monti-tls/repico/RESOURCES.md

Architecture drawing :
  https://docs.google.com/drawings/d/1vPpEyib8iVg671A2u_ITs0JO-gHoYBtKFvb20q2bAPQ/edit

GPIO .dts overlay generator :
  http://kilobaser.com/blog/2014-07-28-beaglebone-black-devicetreeoverlay-generator
