monti-tls/repico/simulation/dda/supply_switch/mosfet_test.asc

M1: nmos; TSM2314CX
R1: res; 1
V1: voltage; 5
V2: voltage; 5
Named nets: 0
.include TSM2314CX.lib
.tran 200m
