monti-tls/repico/simulation/pwm_module/pwm_module.asc

C1: cap; 47µ
C2: cap; 100n
C3: cap; 47µ
C4: cap; 100n
D1: diode; S1D
L1: ind; 0.1µ
Q1: npn; BC847C
Q2: npn; BC847C
Q3: npn; BC847C
Q4: pnp; BC857C
R1: res; 330
R2: res; 3.3K
R3: res; 470
R4: res; 3.3K
R5: res; 4.7
R6: res; 22
R7: res; 3.3
R8: res2; 5; pwr=25
U1: PSMN8R7_80PS
V1: voltage; PULSE(0 3.3 0.2ms 0 0 0.05ms 0.1ms)
V2: voltage; 12
Named nets: 0, VDD, S
.tran 2ms
.lib S1D.lib
.lib PSMN8R7_80PS.lib
