monti-tls/repico/simulation/dda/relay/relay.asc

Q1: npn; BC847C
R1: res; 4K7
R2: res2; 225
R3: res; 20K
V1: voltage; 12
V2: voltage; PULSE(0 3.3 1ms 0 0 1ms 2ms 1)
Named nets: VCC, 0, S
.tran 10ms
