monti-tls/repico/simulation/dda/stepper_leds/stepper_leds.asc

D1: LED
Q1: npn; BC847C
Q2: npn; BC847C
R1: res; 10K
R2: res; 560
R3: res; 4.7K
R4: res; 560
V1: voltage; 12
V2: voltage; PULSE(3.3 0 5ms 0 0 5ms 10ms 1)
Named nets: VCC, 0, S
.tran 15ms
