monti-tls/repico/simulation/dda/supply_switch/supply_switch.asc

C2: cap; 10µ
M1: pmos; RTQ035P02
Q1: npn; BC847C
R1: res; 20k
R3: res; 20k
R4: res2; 3
R5: res; 0
R6: res; 10k
R7: res; 4.7k
V1: voltage; 3.3
V2: voltage; PULSE(0 3.3 10m 0 0 100m 0 1)
Named nets: enbl, 0
.tran 200m
