monti-tls/repico/simulation/dda/switch_debounce/switch_debounce.asc

C1: cap; 100n
D1: diode; 1N4148
R1: res; 3.3K
R2: res; 3.3K
S1: sw; SWITCH
U1: 74hc132; VCC=3.3  SPEED=1.0  TRIPDT=1e-9
V1: voltage; PULSE(0 1 1ms 0 0 0.08ms 0.16ms 5)
V2: voltage; 3.3
V3: voltage; PULSE(0 1 1.8ms 0 0 2ms 2ms)
Named nets: 0, VCC, S
.lib 74hc.lib
.tran 10ms
.model SWITCH SW(Ron=1m Roff=1Meg Vt=0.5 Vh=0.4)
