monti-tls/repico/hardware/dda/dda.brd

## EAGLE design hardware/dda/dda.brd (2016-12-25)

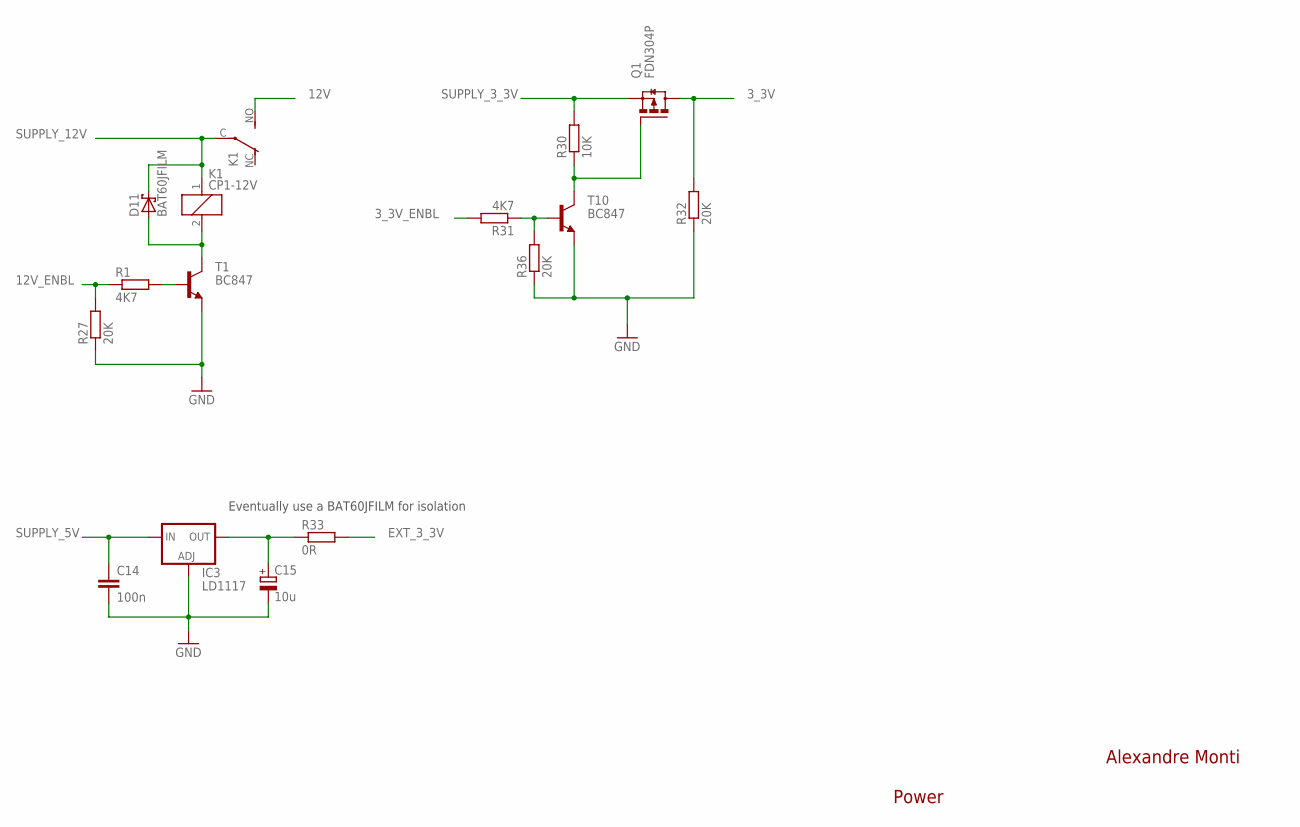
[picture p1: schematic dda.sch, sheet 1, Power]

Parts:
C14: 100n; C0805; PARTNO 2496944
C15: 10u; CT3216; PARTNO 1432339
D11: BAT60JFILM; SOD323_ST; PARTNO 1467544
IC3: LD1117; SOT223; PARTNO 1202826
K1: CP1-12V; CP1; PARTNO 2103582
Q1: FDN304P; SUPER-SOT3; PARTNO 9846298
R1, R31: 4K7; M0805; PARTNO 9333266
R27, R32, R36: 20K; M0805; PARTNO 9332774
R30: 10K; M0805; PARTNO 9332391
R33: 0R; R0805W; PARTNO 9333681
T1, T10: BC847; SOT23; PARTNO 2432696

Connections:
3_3V: Q1.3 (D), R32.2; also elsewhere on the board
3_3V_ENBL: R31.2; also elsewhere on the board
12V: K1.NO (S); also elsewhere on the board
12V_ENBL: R1.1, R27.2; also elsewhere on the board
EXT_3_3V: R33.2; also elsewhere on the board
GND: C14.2, C15.-, IC3.1 (ADJ), R27.1, R32.1, R36.1, T1.2 (E), T10.2 (E); also elsewhere on the board
unnamed: Q1.1 (G), R30.1, T10.3 (C)
unnamed: R31.1, R36.2, T10.1 (B)
unnamed: C15.+, IC3.4 (OUT), R33.1
unnamed: D11.A, K1.2, T1.3 (C)
unnamed: R1.2, T1.1 (B)
SUPPLY_3_3V: Q1.2 (S), R30.2; also elsewhere on the board
SUPPLY_5V: C14.1, IC3.3 (IN); also elsewhere on the board
SUPPLY_12V: D11.C, K1.1, K1.C; also elsewhere on the board

Notes on the sheet:
Alexandre Monti
Eventually use a BAT60JFILM for isolation
Power

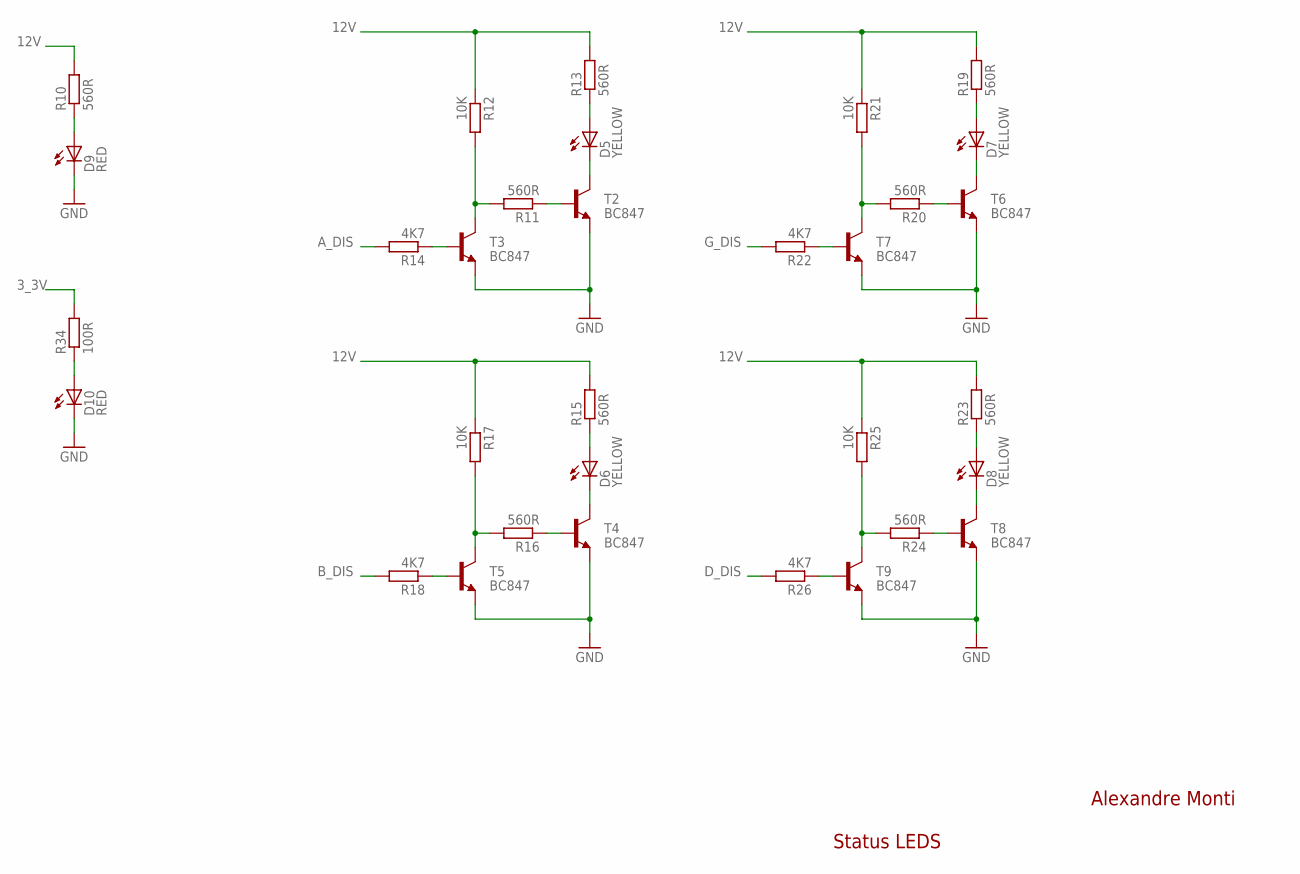
[picture p2: schematic dda.sch, sheet 2, LEDs]

Parts:
D5, D6, D7, D8: YELLOW; CHIP-LED0805; PARTNO 1581241
D9, D10: RED; CHIP-LED0805; PARTNO 1581239
R10, R11, R13, R15, R16, R19, R20, R23, R24: 560R; M0805; PARTNO 9334688
R12, R17, R21, R25: 10K; M0805; PARTNO 9332391
R14, R18, R22, R26: 4K7; M0805; PARTNO 9333266
R34: 100R; M0805; PARTNO 9237364
T2, T3, T4, T5, T6, T7, T8, T9: BC847; SOT23; PARTNO 2432696

Connections:
3_3V: R34.2; also elsewhere on the board
12V: R10.2, R12.1, R13.2, R15.2, R17.1, R19.2, R21.1, R23.2, R25.1; also elsewhere on the board
A_DIS: R14.2; also elsewhere on the board
B_DIS: R18.2; also elsewhere on the board
D_DIS: R26.2; also elsewhere on the board
GND: D9.C, D10.C, T2.2 (E), T3.2 (E), T4.2 (E), T5.2 (E), T6.2 (E), T7.2 (E), T8.2 (E), T9.2 (E); also elsewhere on the board
G_DIS: R22.2; also elsewhere on the board
unnamed: D10.A, R34.1
unnamed: D5.C, T2.3 (C)
unnamed: D5.A, R13.1
unnamed: R11.1, T2.1 (B)
unnamed: R11.2, R12.2, T3.3 (C)
unnamed: D6.C, T4.3 (C)
unnamed: R14.1, T3.1 (B)
unnamed: D6.A, R15.1
unnamed: R16.1, T4.1 (B)
unnamed: R16.2, R17.2, T5.3 (C)
unnamed: R18.1, T5.1 (B)
unnamed: D7.C, T6.3 (C)
unnamed: D7.A, R19.1
unnamed: R20.1, T6.1 (B)
unnamed: R20.2, R21.2, T7.3 (C)
unnamed: R22.1, T7.1 (B)
unnamed: D8.C, T8.3 (C)
unnamed: D8.A, R23.1
unnamed: R24.1, T8.1 (B)
unnamed: R24.2, R25.2, T9.3 (C)
unnamed: R26.1, T9.1 (B)
unnamed: D9.A, R10.1

Notes on the sheet:
Alexandre Monti
Status LEDS

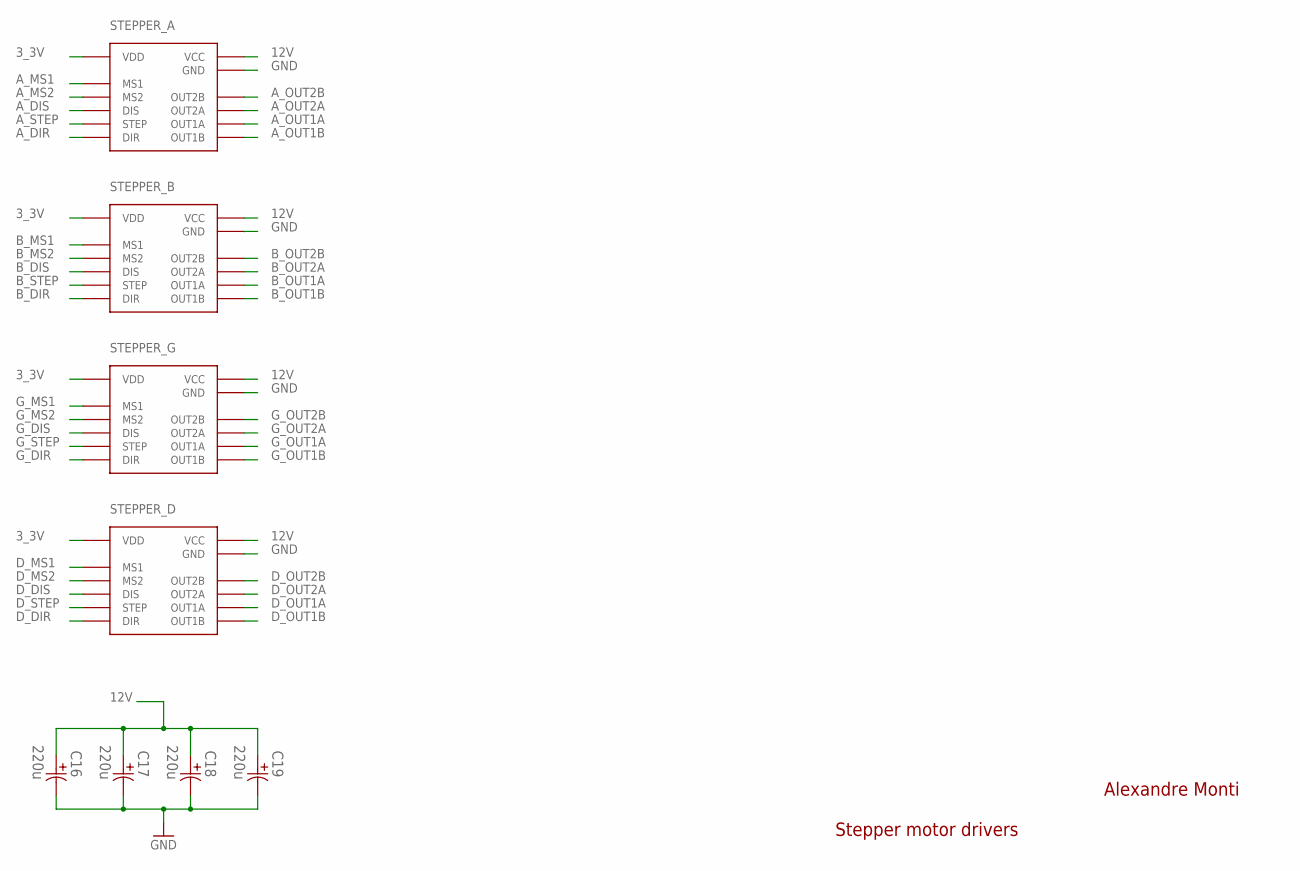
[picture p3: schematic dda.sch, sheet 3, Steppers]

Parts:
C16, C17, C18, C19: 220u; CAPAE660X800N; PARTNO 1868409
STEPPER_A: REPICO_STEPPER; PARTNO 1593462
STEPPER_B: REPICO_STEPPER; PARTNO 1593462
STEPPER_D: REPICO_STEPPER; PARTNO 1593462
STEPPER_G: REPICO_STEPPER; PARTNO 1593462

Connections:
3_3V: STEPPER_A.VDD, STEPPER_B.VDD, STEPPER_D.VDD, STEPPER_G.VDD; also elsewhere on the board
12V: C16.1, C17.1, C18.1, C19.1, STEPPER_A.VCC, STEPPER_B.VCC, STEPPER_D.VCC, STEPPER_G.VCC; also elsewhere on the board
A_DIR: STEPPER_A.DIR; also elsewhere on the board
A_DIS: STEPPER_A.DIS; also elsewhere on the board
A_MS1: STEPPER_A.MS1; also elsewhere on the board
A_MS2: STEPPER_A.MS2; also elsewhere on the board
A_OUT1A: STEPPER_A.OUT1A; also elsewhere on the board
A_OUT1B: STEPPER_A.OUT1B; also elsewhere on the board
A_OUT2A: STEPPER_A.OUT2A; also elsewhere on the board
A_OUT2B: STEPPER_A.OUT2B; also elsewhere on the board
A_STEP: STEPPER_A.STEP; also elsewhere on the board
B_DIR: STEPPER_B.DIR; also elsewhere on the board
B_DIS: STEPPER_B.DIS; also elsewhere on the board
B_MS1: STEPPER_B.MS1; also elsewhere on the board
B_MS2: STEPPER_B.MS2; also elsewhere on the board
B_OUT1A: STEPPER_B.OUT1A; also elsewhere on the board
B_OUT1B: STEPPER_B.OUT1B; also elsewhere on the board
B_OUT2A: STEPPER_B.OUT2A; also elsewhere on the board
B_OUT2B: STEPPER_B.OUT2B; also elsewhere on the board
B_STEP: STEPPER_B.STEP; also elsewhere on the board
D_DIR: STEPPER_D.DIR; also elsewhere on the board
D_DIS: STEPPER_D.DIS; also elsewhere on the board
D_MS1: STEPPER_D.MS1; also elsewhere on the board
D_MS2: STEPPER_D.MS2; also elsewhere on the board
D_OUT1A: STEPPER_D.OUT1A; also elsewhere on the board
D_OUT1B: STEPPER_D.OUT1B; also elsewhere on the board
D_OUT2A: STEPPER_D.OUT2A; also elsewhere on the board
D_OUT2B: STEPPER_D.OUT2B; also elsewhere on the board
D_STEP: STEPPER_D.STEP; also elsewhere on the board
GND: C16.2, C17.2, C18.2, C19.2, STEPPER_A.GND, STEPPER_B.GND, STEPPER_D.GND, STEPPER_G.GND; also elsewhere on the board
G_DIR: STEPPER_G.DIR; also elsewhere on the board
G_DIS: STEPPER_G.DIS; also elsewhere on the board
G_MS1: STEPPER_G.MS1; also elsewhere on the board
G_MS2: STEPPER_G.MS2; also elsewhere on the board
G_OUT1A: STEPPER_G.OUT1A; also elsewhere on the board
G_OUT1B: STEPPER_G.OUT1B; also elsewhere on the board
G_OUT2A: STEPPER_G.OUT2A; also elsewhere on the board
G_OUT2B: STEPPER_G.OUT2B; also elsewhere on the board
G_STEP: STEPPER_G.STEP; also elsewhere on the board

Notes on the sheet:
Stepper motor drivers
Alexandre Monti

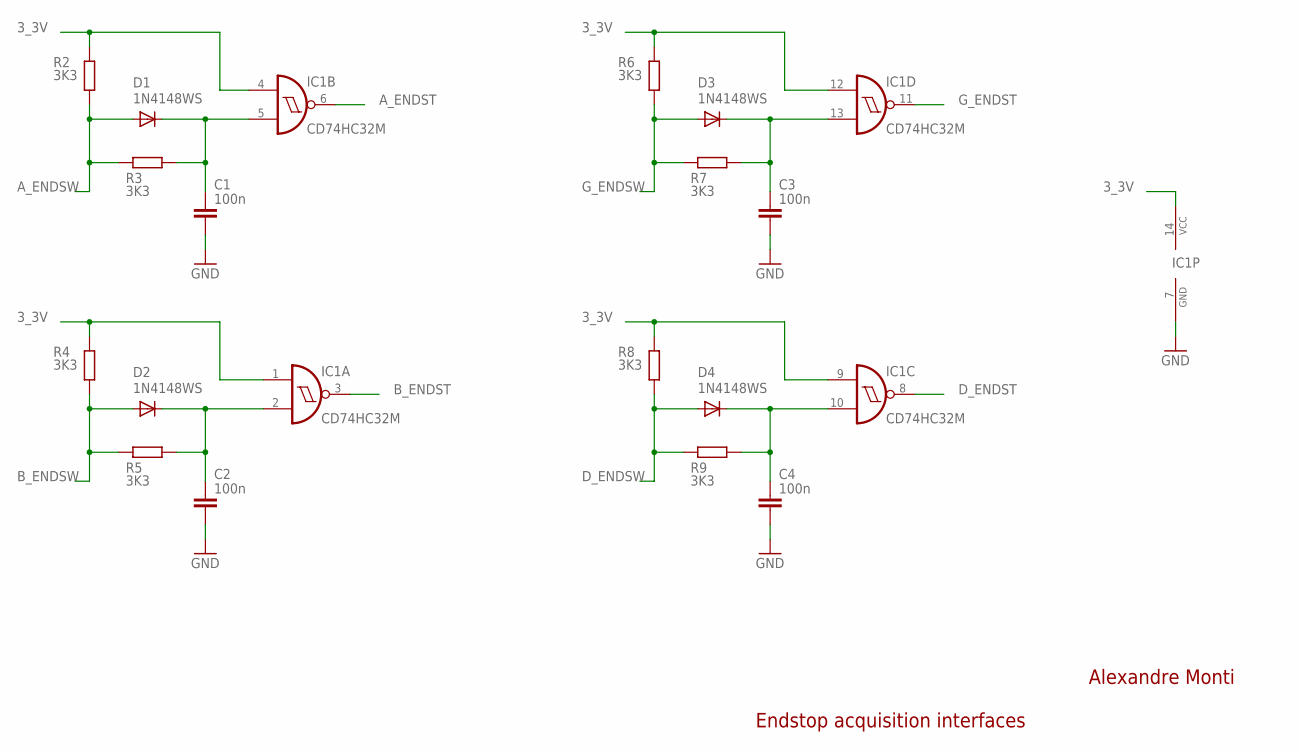
[picture p4: schematic dda.sch, sheet 4, Endstops]

Parts:
C1, C2, C3, C4: 100n; C0805; PARTNO 2496944
D1, D2, D3, D4: 1N4148WS; SOD123; PARTNO 1466524
IC1: CD74HC32M; SO14; PARTNO 1103158
R2, R3, R4, R5, R6, R7, R8, R9: 3K3; M0805; PARTNO 9333045

Connections:
3_3V: IC1.1 (I0), IC1.4 (I0), IC1.9 (I0), IC1.12 (I0), IC1.14 (VCC), R2.2, R4.2, R6.2, R8.2; also elsewhere on the board
A_ENDST: IC1.6 (O); also elsewhere on the board
A_ENDSW: D1.A, R2.1, R3.1; also elsewhere on the board
B_ENDST: IC1.3 (O); also elsewhere on the board
B_ENDSW: D2.A, R4.1, R5.1; also elsewhere on the board
D_ENDST: IC1.8 (O); also elsewhere on the board
D_ENDSW: D4.A, R8.1, R9.1; also elsewhere on the board
GND: C1.2, C2.2, C3.2, C4.2, IC1.7 (GND); also elsewhere on the board
G_ENDST: IC1.11 (O); also elsewhere on the board
G_ENDSW: D3.A, R6.1, R7.1; also elsewhere on the board
unnamed: C1.1, D1.C, IC1.5 (I1), R3.2
unnamed: C2.1, D2.C, IC1.2 (I1), R5.2
unnamed: C3.1, D3.C, IC1.13 (I1), R7.2
unnamed: C4.1, D4.C, IC1.10 (I1), R9.2

Notes on the sheet:
Alexandre Monti
Endstop acquisition interfaces

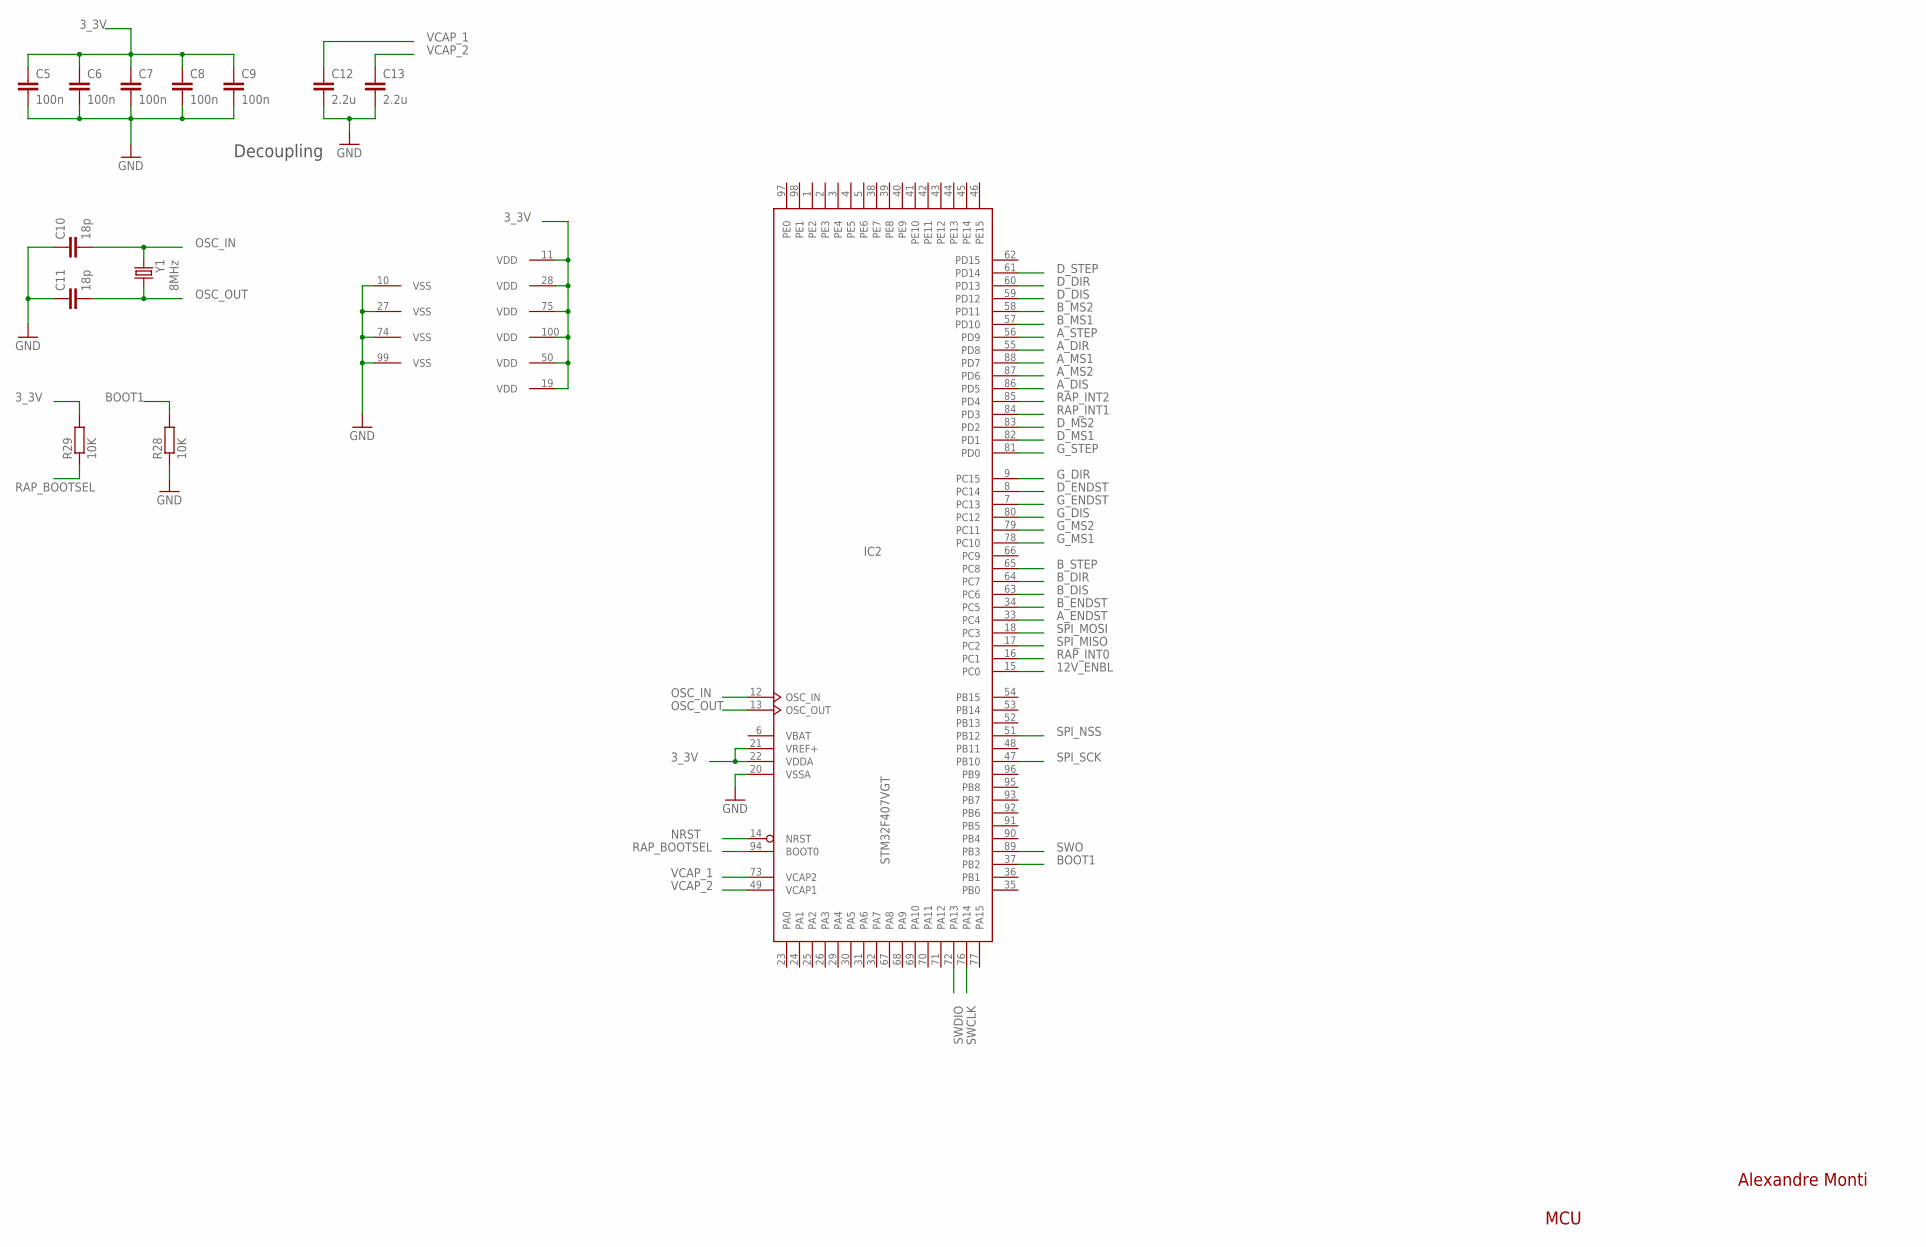
[picture p5: schematic dda.sch, sheet 5, MCU]

Parts:
C5, C6, C7, C8, C9: 100n; C0805; PARTNO 2496944
C10, C11: 18p; C0805; PARTNO 1414673
C12, C13: 2.2u; C1206; PARTNO 1759477
IC2: STM32F407VGT; LQFP100; PARTNO 2064368
R28, R29: 10K; M0805; PARTNO 9332391
Y1: 8MHz; CRYSTAL-SMD-5X3.2; PARTNO 2101329

Connections:
3_3V: C5.1, C6.1, C7.1, C8.1, C9.1, IC2.11 (VDD), IC2.19 (VDD), IC2.21 (VREF+), IC2.22 (VDDA), IC2.28 (VDD), IC2.50 (VDD), IC2.75 (VDD), IC2.100 (VDD), R29.2; also elsewhere on the board
12V_ENBL: IC2.15 (PC0); also elsewhere on the board
A_DIR: IC2.55 (PD8); also elsewhere on the board
A_DIS: IC2.86 (PD5); also elsewhere on the board
A_ENDST: IC2.33 (PC4); also elsewhere on the board
A_MS1: IC2.88 (PD7); also elsewhere on the board
A_MS2: IC2.87 (PD6); also elsewhere on the board
A_STEP: IC2.56 (PD9); also elsewhere on the board
BOOT1: IC2.37 (PB2), R28.2
B_DIR: IC2.64 (PC7); also elsewhere on the board
B_DIS: IC2.63 (PC6); also elsewhere on the board
B_ENDST: IC2.34 (PC5); also elsewhere on the board
B_MS1: IC2.57 (PD10); also elsewhere on the board
B_MS2: IC2.58 (PD11); also elsewhere on the board
B_STEP: IC2.65 (PC8); also elsewhere on the board
D_DIR: IC2.60 (PD13); also elsewhere on the board
D_DIS: IC2.59 (PD12); also elsewhere on the board
D_ENDST: IC2.8 (PC14); also elsewhere on the board
D_MS1: IC2.82 (PD1); also elsewhere on the board
D_MS2: IC2.83 (PD2); also elsewhere on the board
D_STEP: IC2.61 (PD14); also elsewhere on the board
GND: C5.2, C6.2, C7.2, C8.2, C9.2, C10.1, C11.1, C12.2, C13.2, IC2.10 (VSS), IC2.20 (VSSA), IC2.27 (VSS), IC2.74 (VSS), IC2.99 (VSS), R28.1; also elsewhere on the board
G_DIR: IC2.9 (PC15); also elsewhere on the board
G_DIS: IC2.80 (PC12); also elsewhere on the board
G_ENDST: IC2.7 (PC13); also elsewhere on the board
G_MS1: IC2.78 (PC10); also elsewhere on the board
G_MS2: IC2.79 (PC11); also elsewhere on the board
G_STEP: IC2.81 (PD0); also elsewhere on the board
NRST: IC2.14 (NRST); also elsewhere on the board
OSC_IN: C10.2, IC2.12 (OSC_IN), Y1.P$2 (2)
OSC_OUT: C11.2, IC2.13 (OSC_OUT), Y1.P$1 (1)
RAP_BOOTSEL: IC2.94 (BOOT0), R29.1; also elsewhere on the board
RAP_INT0: IC2.16 (PC1); also elsewhere on the board
RAP_INT1: IC2.84 (PD3); also elsewhere on the board
RAP_INT2: IC2.85 (PD4); also elsewhere on the board
SPI_MISO: IC2.17 (PC2); also elsewhere on the board
SPI_MOSI: IC2.18 (PC3); also elsewhere on the board
SPI_NSS: IC2.51 (PB12); also elsewhere on the board
SPI_SCK: IC2.47 (PB10); also elsewhere on the board
SWCLK: IC2.76 (PA14); also elsewhere on the board
SWDIO: IC2.72 (PA13); also elsewhere on the board
SWO: IC2.89 (PB3); also elsewhere on the board
VBAT: IC2.6 (VBAT)
VCAP_1: C12.1, IC2.73 (VCAP2)
VCAP_2: C13.1, IC2.49 (VCAP1)

Notes on the sheet:
Decoupling
Alexandre Monti
MCU

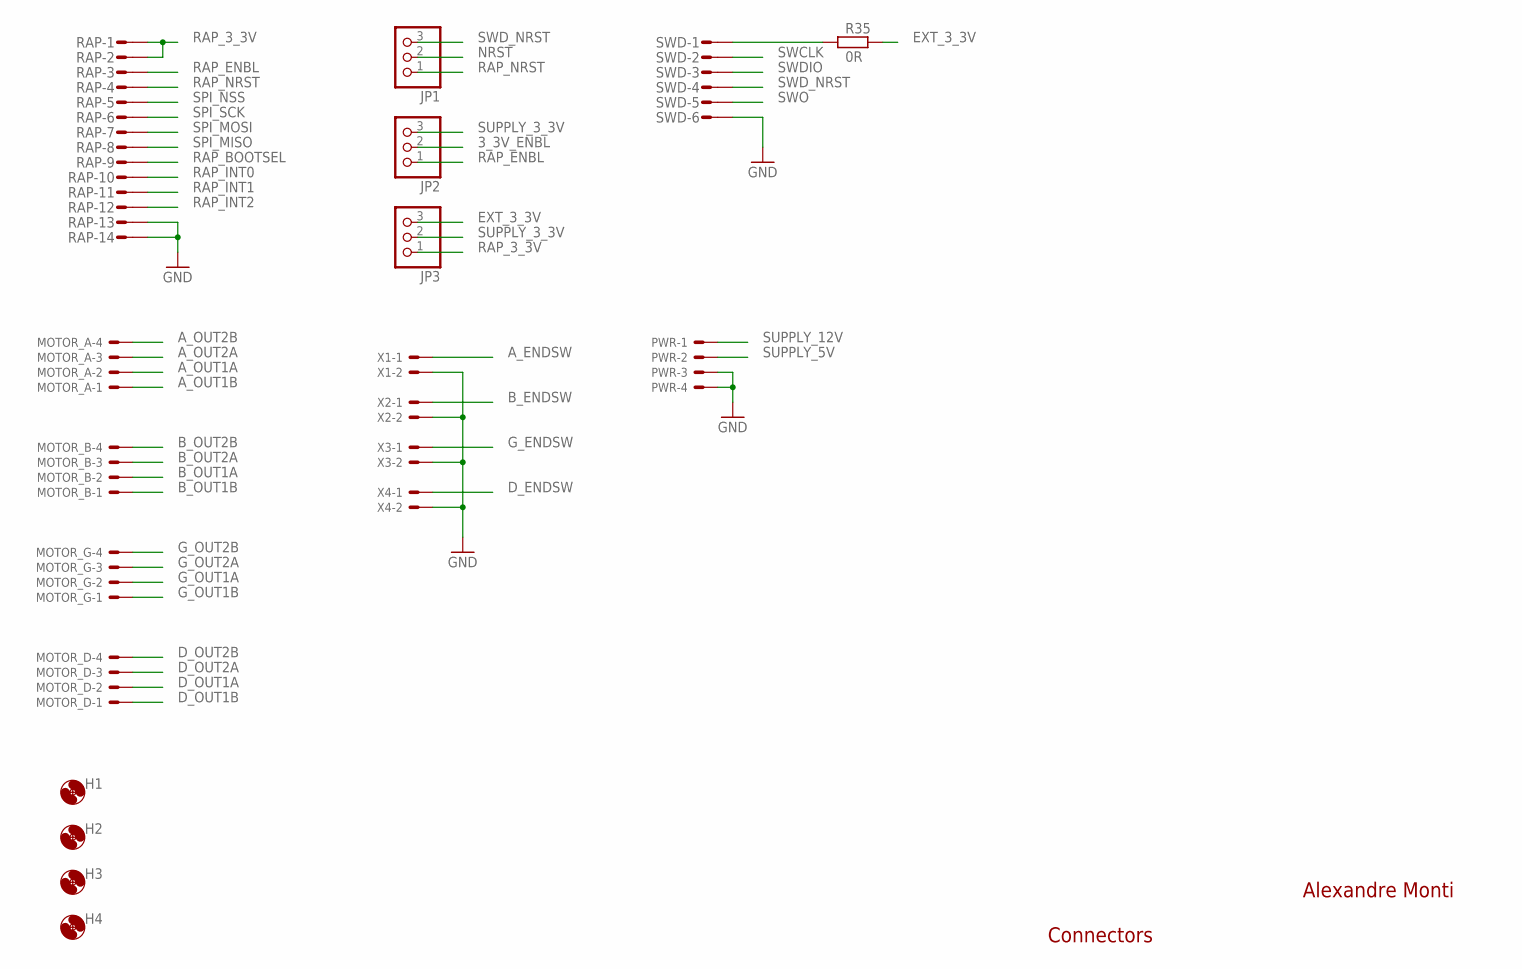
[picture p6: schematic dda.sch, sheet 6, Connectors]

Parts:
H1, H2, H3, H4: MOUNT-HOLE3.2; 3,2
JP1, JP2, JP3: PINHD-1X03_2.00; 1X03M; PARTNO 2289777
MOTOR_A: 22-23-2041; PARTNO 588593
MOTOR_B: 22-23-2041; PARTNO 588593
MOTOR_D: 22-23-2041; PARTNO 588593
MOTOR_G: 22-23-2041; PARTNO 588593
PWR: 22-23-2041; PARTNO 588593
R35: 0R; R0805W; PARTNO 9333681
RAP: MICROMATCH-14; MATE_PARTNO 149135
SWD: MICROMATCH-6; MATE_PARTNO 149068
X1, X2, X3, X4: 22-23-2021; PARTNO 588570

Connections:
3_3V_ENBL: JP2.2; also elsewhere on the board
A_ENDSW: X1.1; also elsewhere on the board
A_OUT1A: MOTOR_A.2; also elsewhere on the board
A_OUT1B: MOTOR_A.1; also elsewhere on the board
A_OUT2A: MOTOR_A.3; also elsewhere on the board
A_OUT2B: MOTOR_A.4; also elsewhere on the board
B_ENDSW: X2.1; also elsewhere on the board
B_OUT1A: MOTOR_B.2; also elsewhere on the board
B_OUT1B: MOTOR_B.1; also elsewhere on the board
B_OUT2A: MOTOR_B.3; also elsewhere on the board
B_OUT2B: MOTOR_B.4; also elsewhere on the board
D_ENDSW: X4.1; also elsewhere on the board
D_OUT1A: MOTOR_D.2; also elsewhere on the board
D_OUT1B: MOTOR_D.1; also elsewhere on the board
D_OUT2A: MOTOR_D.3; also elsewhere on the board
D_OUT2B: MOTOR_D.4; also elsewhere on the board
EXT_3_3V: JP3.3, R35.2; also elsewhere on the board
GND: PWR.3, PWR.4, RAP.13, RAP.14, SWD.6, X1.2, X2.2, X3.2, X4.2; also elsewhere on the board
G_ENDSW: X3.1; also elsewhere on the board
G_OUT1A: MOTOR_G.2; also elsewhere on the board
G_OUT1B: MOTOR_G.1; also elsewhere on the board
G_OUT2A: MOTOR_G.3; also elsewhere on the board
G_OUT2B: MOTOR_G.4; also elsewhere on the board
unnamed: R35.1, SWD.1
NRST: JP1.2; also elsewhere on the board
RAP_3_3V: JP3.1, RAP.1, RAP.2
RAP_BOOTSEL: RAP.9; also elsewhere on the board
RAP_ENBL: JP2.1, RAP.3
RAP_INT0: RAP.10; also elsewhere on the board
RAP_INT1: RAP.11; also elsewhere on the board
RAP_INT2: RAP.12; also elsewhere on the board
RAP_NRST: JP1.1, RAP.4
SPI_MISO: RAP.8; also elsewhere on the board
SPI_MOSI: RAP.7; also elsewhere on the board
SPI_NSS: RAP.5; also elsewhere on the board
SPI_SCK: RAP.6; also elsewhere on the board
SUPPLY_3_3V: JP2.3, JP3.2; also elsewhere on the board
SUPPLY_5V: PWR.2; also elsewhere on the board
SUPPLY_12V: PWR.1; also elsewhere on the board
SWCLK: SWD.2; also elsewhere on the board
SWDIO: SWD.3; also elsewhere on the board
SWD_NRST: JP1.3, SWD.4
SWO: SWD.5; also elsewhere on the board

Notes on the sheet:
Alexandre Monti
Connectors

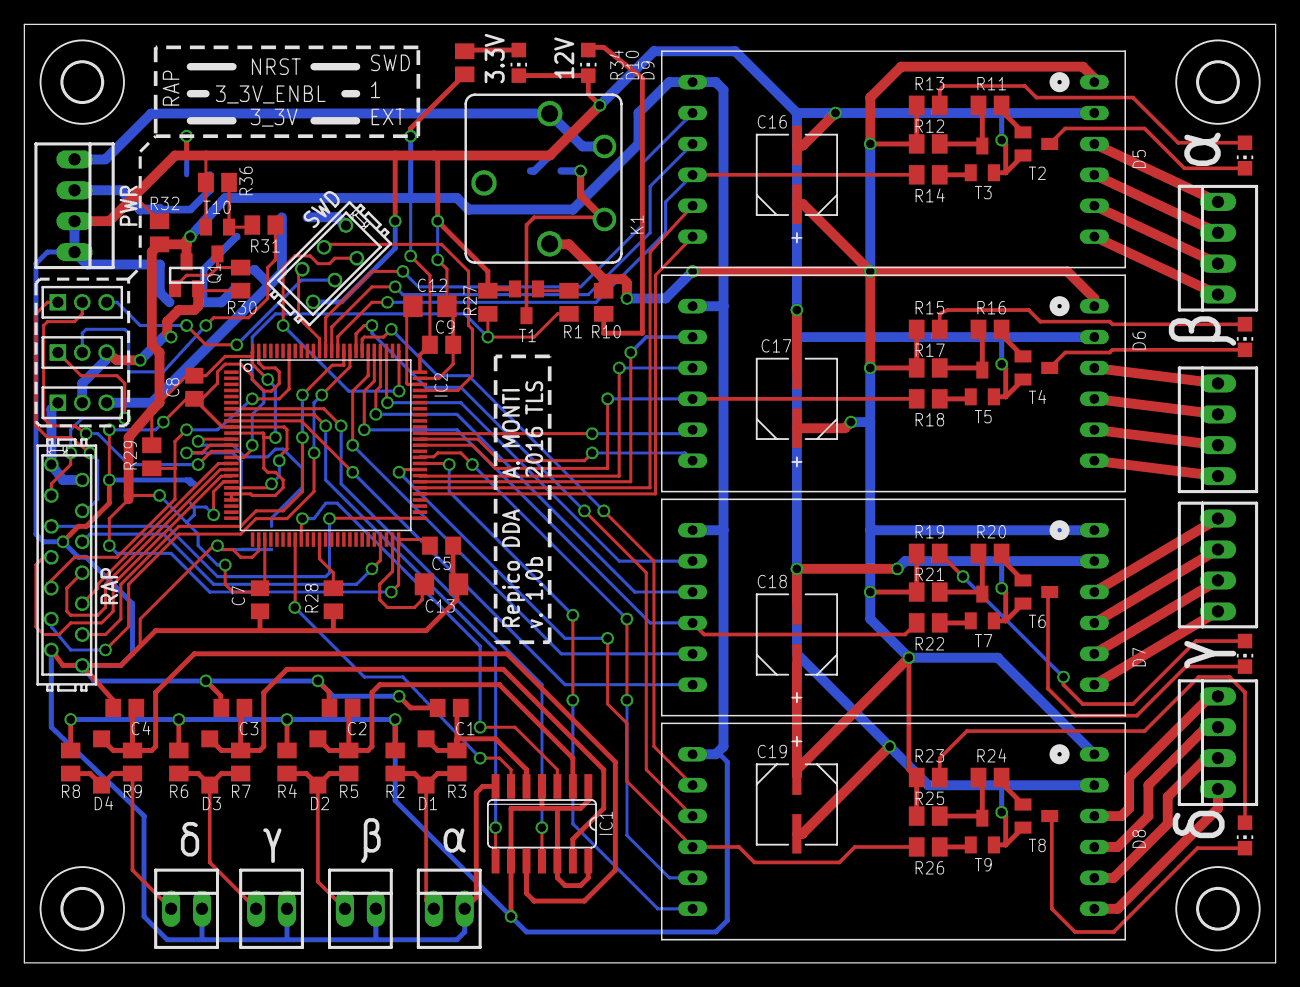
[picture p7: board dda.brd from above]

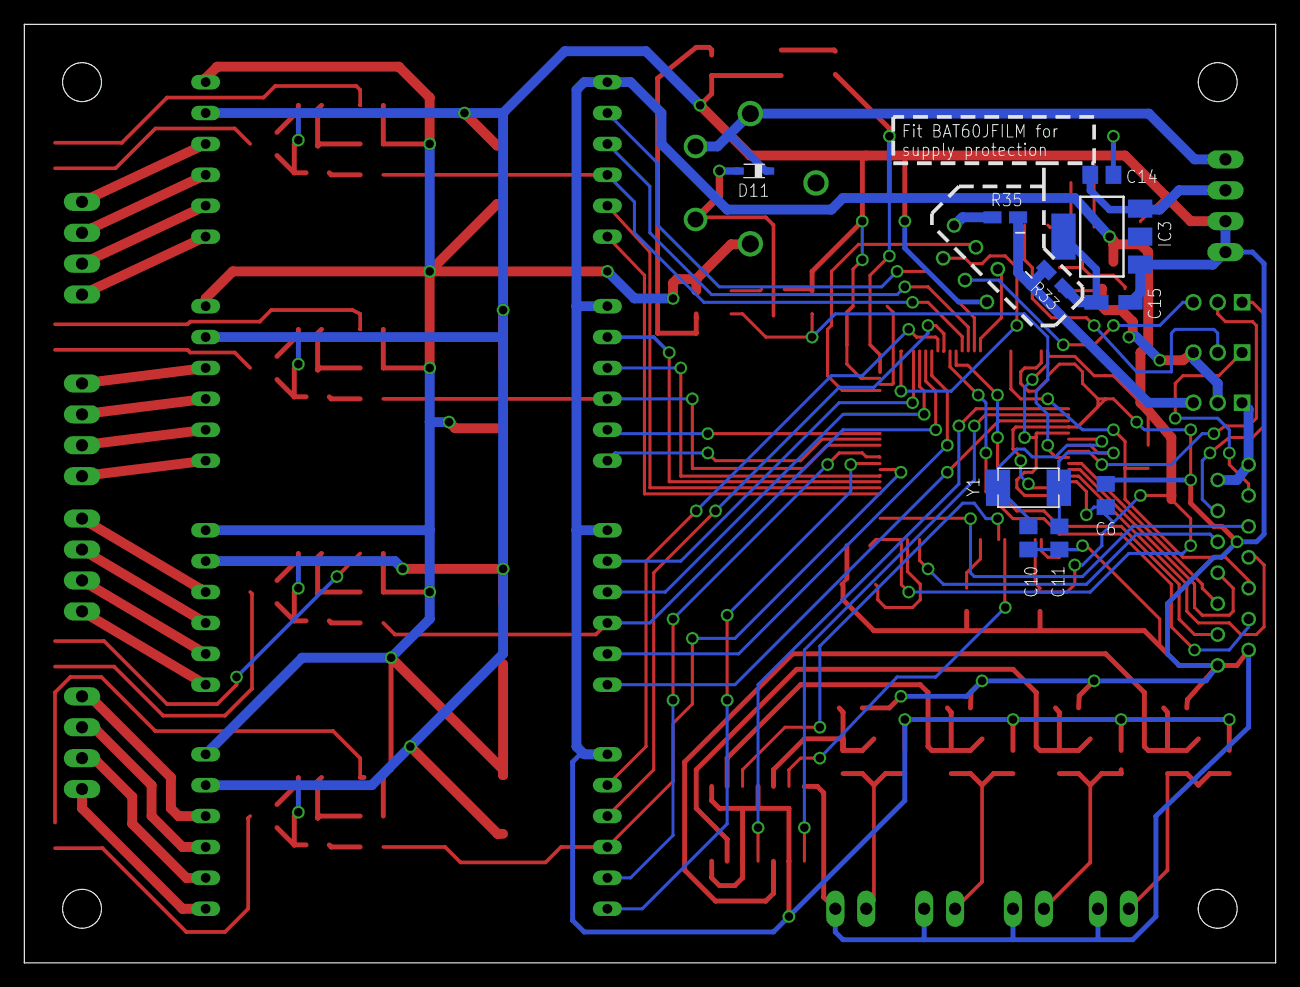
[picture p8: board dda.brd from below]

Board: 2 copper layers, 102.8 x 77.1 mm, 104 parts (10 on the bottom side), 106 nets.
