monti-tls/repico/hardware/stepper_module/stepper_module.brd

## EAGLE design hardware/stepper_module/stepper_module.brd (2015-11-13)

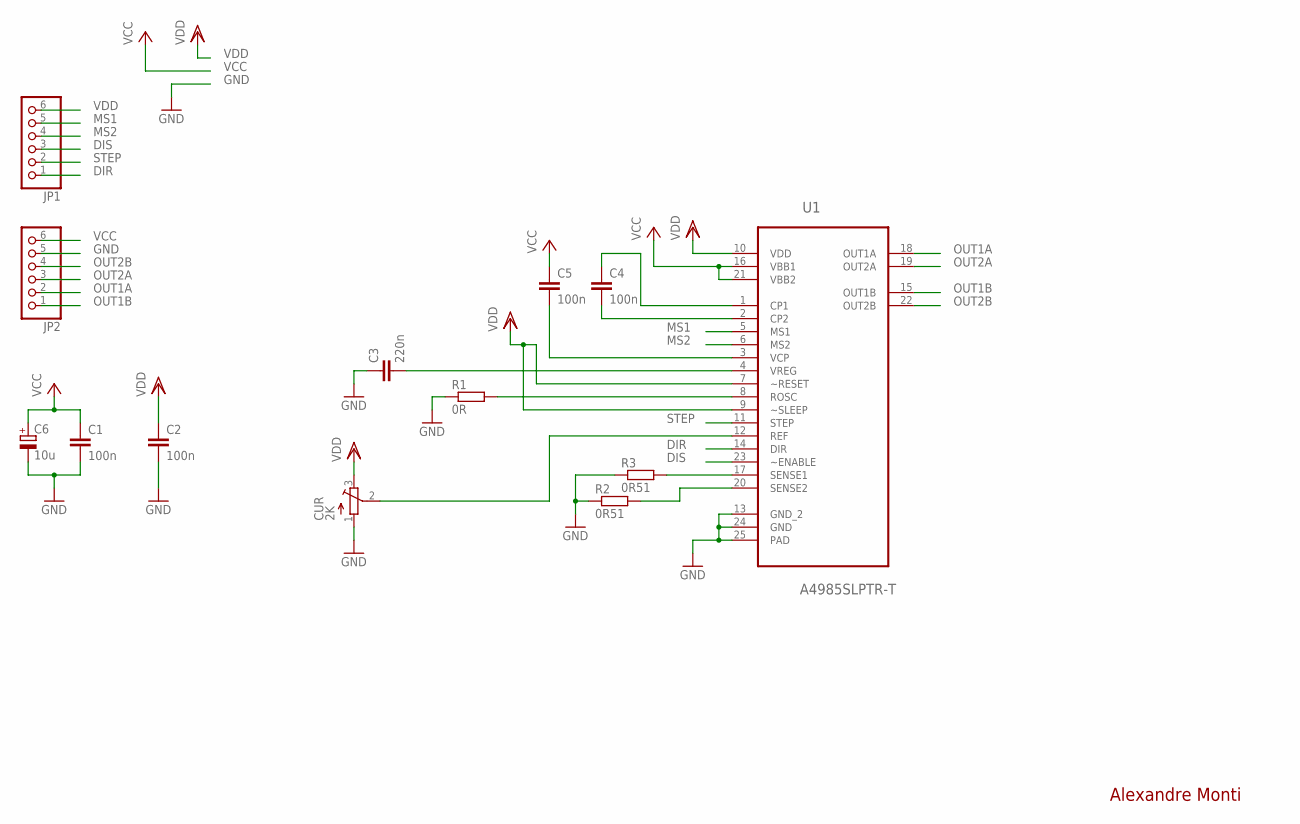
[picture p9: schematic stepper_module.sch]

Parts:
C1, C2, C4, C5: 100n; C0805
C3: 220n; C0805
C6: 10u; SMC_B
CUR: 2K; TC33X
JP1, JP2: PINHD-1X6; 1X06
R1: 0R; R0805
R2, R3: 0R51; R0805
U1: A4985SLPTR-T; SOP65P640X120-25N

Connections:
DIR: JP1.1, U1.14 (DIR)
DIS: JP1.3, U1.23 (~ENABLE)
GND: C1.2, C2.2, C3.1, C6.-, CUR.1 (A), JP2.5, R1.1, R2.1, R3.1, U1.13 (GND_2), U1.24 (GND), U1.25 (PAD)
MS1: JP1.5, U1.5 (MS1)
MS2: JP1.4, U1.6 (MS2)
unnamed: C4.2, U1.2 (CP2)
unnamed: C4.1, U1.1 (CP1)
unnamed: C5.2, U1.3 (VCP)
unnamed: C3.2, U1.4 (VREG)
unnamed: R3.2, U1.17 (SENSE1)
unnamed: R2.2, U1.20 (SENSE2)
unnamed: R1.2, U1.8 (ROSC)
unnamed: CUR.2 (S), U1.12 (REF)
OUT1A: JP2.2, U1.18 (OUT1A)
OUT1B: JP2.1, U1.15 (OUT1B)
OUT2A: JP2.3, U1.19 (OUT2A)
OUT2B: JP2.4, U1.22 (OUT2B)
STEP: JP1.2, U1.11 (STEP)
VCC: C1.1, C5.1, C6.+, JP2.6, U1.16 (VBB1), U1.21 (VBB2)
VDD: C2.1, CUR.3 (E), JP1.6, U1.7 (~RESET), U1.9 (~SLEEP), U1.10 (VDD)

Notes on the sheet:
Alexandre Monti

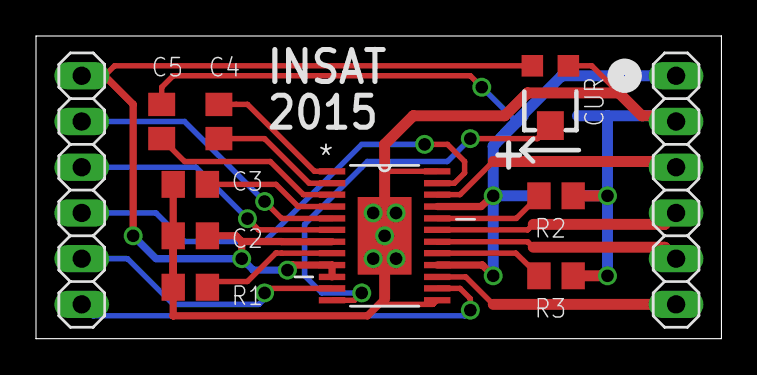
[picture p10: board stepper_module.brd from above]

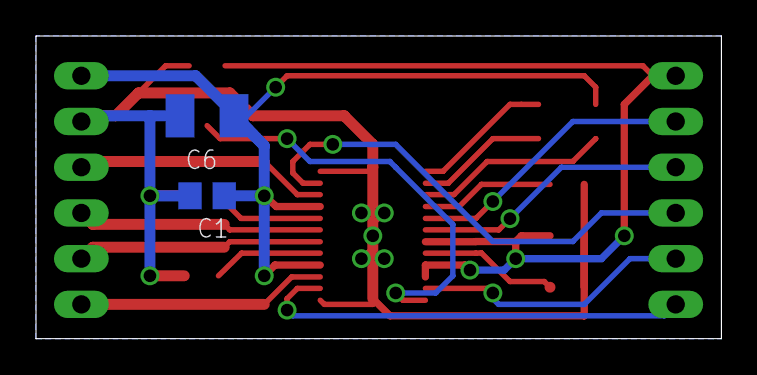
[picture p11: board stepper_module.brd from below]

Board: 2 copper layers, 38.1 x 16.8 mm, 13 parts (2 on the bottom side), 20 nets.
