monti-tls/repico/hardware/pwm_module/pwm_module.brd

## EAGLE design hardware/pwm_module/pwm_module.brd (2015-11-13)

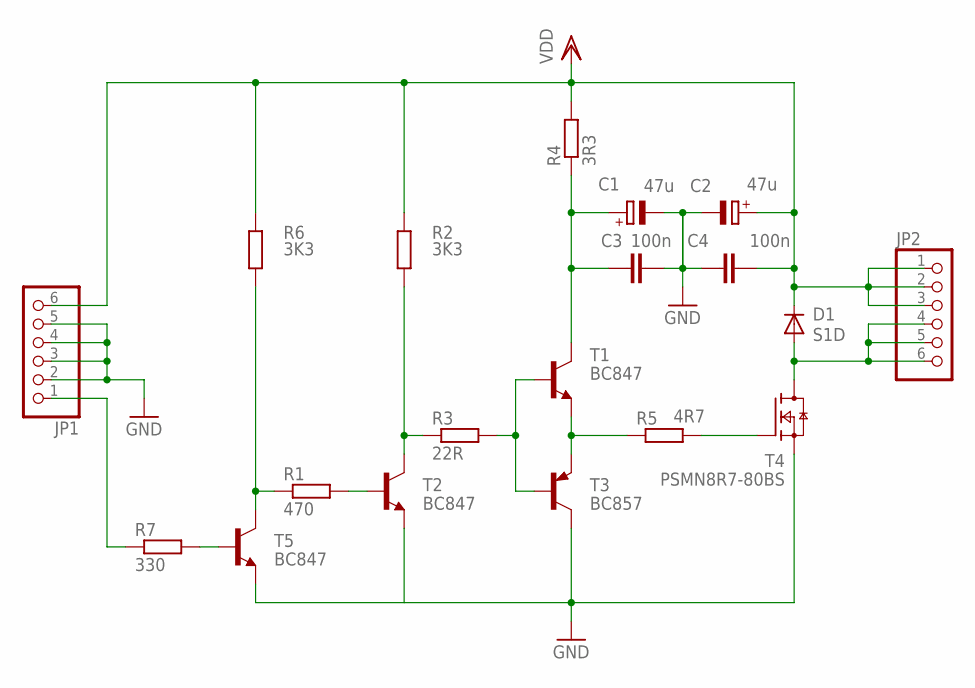
[picture p12: schematic pwm_module.sch]

Parts:
C1, C2: 47u; PANASONIC_F; FARNELL 9696032
C3, C4: 100n; C1206K; FARNELL 1759366
D1: S1D; DO-214AC; FARNELL 2454091
JP1, JP2: PINHD-1X6; 1X06
R1: 470; M0805
R2, R6: 3K3; M0805
R3: 22R; M0805
R4: 3R3; M0805
R5: 4R7; M0805
R7: 330; M0805
T1, T2, T5: BC847; SOT23; FARNELL 2432696
T3: BC857; SOT23-BEC; FARNELL 8734771
T4: PSMN8R7-80BS; SOT404; FARNELL 2112547

Connections:
GND: C1.-, C2.-, C3.2, C4.2, JP1.2, JP1.3, JP1.4, JP1.5, T2.2 (E), T3.C, T4.3 (S), T5.2 (E)
unnamed: R5.1, T1.2 (E), T3.E
unnamed: R5.2, T4.1 (G)
unnamed: R3.2, T1.1 (B), T3.B
unnamed: R2.1, R3.1, T2.3 (C)
unnamed: R1.2, T2.1 (B)
unnamed: JP1.1, R7.1
unnamed: D1.A, JP2.4, JP2.5, JP2.6, T4.MB (D)
unnamed: C1.+, C3.1, R4.1, T1.3 (C)
unnamed: R1.1, R6.1, T5.3 (C)
unnamed: R7.2, T5.1 (B)
V+: C2.+, C4.1, D1.C, JP1.6, JP2.1, JP2.2, JP2.3, R2.2, R4.2, R6.2

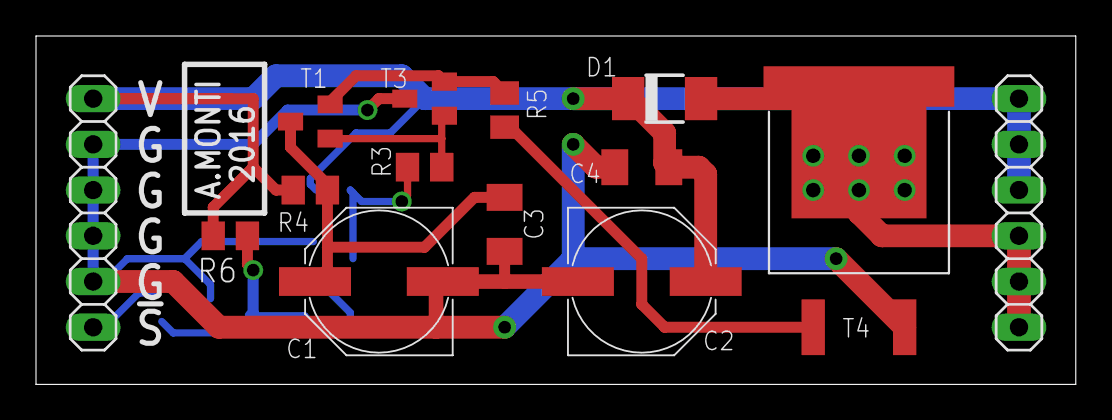
[picture p13: board pwm_module.brd from above]

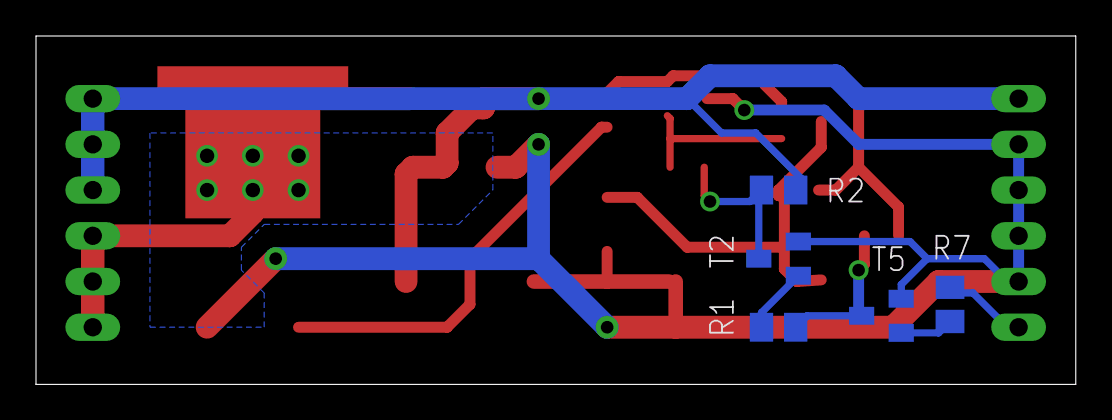
[picture p14: board pwm_module.brd from below]

Board: 2 copper layers, 57.8 x 19.4 mm, 19 parts (5 on the bottom side), 12 nets.
