monti-tls/repico/(commit log)

2015-11-12 Minor changes to rapdev driver
2015-11-12 Added BBB side RAP over SPI basics
    - added a dvice tree overlay for SPI0 (to be renamed later)
    - added a RAP device driver module (empty for the moment, but correctly bound)
    [rap.c]
2015-11-12 RAP/SPI R/W works :)
2015-11-12 Fiddled with RAP SPI to have a full duplex communication (w/ 16 bit words)
2015-11-13 Finally, SPI seems to work
2015-11-13 Added Netlink interface to rapdev kernel device driver with example userspace usage
2016-12-11 Finaly a correct example for SPI2 on the EIFM cortex
    [main.c]
2016-12-12 Changed SPI word size to 16, works with RAP BBB module
2016-12-13 Added hardware / simulation parts :
    - existing stepper driver board (simplified)
    - new PWM module (untested), with LTSpice model
    - part of the DDA schematic / board with design LTSpice models
    [dda.brd, dda.sch, pwm_module.brd, pwm_module.sch, stepper_module.brd, stepper_module.sch]
2016-12-15 Finally, SPI seems to work (ECU side)
2016-12-18 Added ecu/librap for RAP/SPI port, plus some refactoring
2016-12-18 Fixed include in libecu
    [rap.h]
2016-12-25 DDA board routed v1.0b
    [dda.brd, dda.sch]
